Eddie-He-090/Course-Design-2/README.md

# 课程设计2
## 宽带直流程控放大器
### 设计基本要求：
1. 放大器的电压增益AV可预置并显示，最大电压增益AV≥40dB，输入电压有效值Vi≤20mV。AV可在0～40dB范围内调节，步距1dB;
2. 3dB通频带0～10MHz；
3. 在0～8MHz通频带内增益起伏≤1dB；
4. 负载电阻为50欧姆。

*最终成品性能基本满足设计基本要求*

**具体测试结果记录在"A1数据.docx"及"A1数据.slsx"**

设计思路：
1. 前级放大。芯片：AD818。
2. 中间级实现程控可调放大。芯片：AD603。程控MCU：STM32。
3. 后级功率放大。芯片：THS3091。

**详细实验报告：A1 宽带直流程控放大器.docx**
