Eddie-He-090/Course-Design-2/(list of files, drawings)

Other design files:
Multisim/AD603+1.ms14
Multisim/AD603.ms14
Multisim/AD818.ms14
Multisim/THS3091.ms14
