Eddie-He-090/Course-Design-2/(notices)

Notices in the files:
STM32 DAC - 副本/HARDWARE/DAC/dac.c:
Copyright(C) ¹ãÖÝÊÐÐÇÒíµç×Ó¿Æ¼¼ÓÐÏÞ¹«Ë¾ 2009-2019
All rights reserved
